Telekatz/Voron-Mods/Clockwork2 CAN/README.md

# Clockwork2 CAN

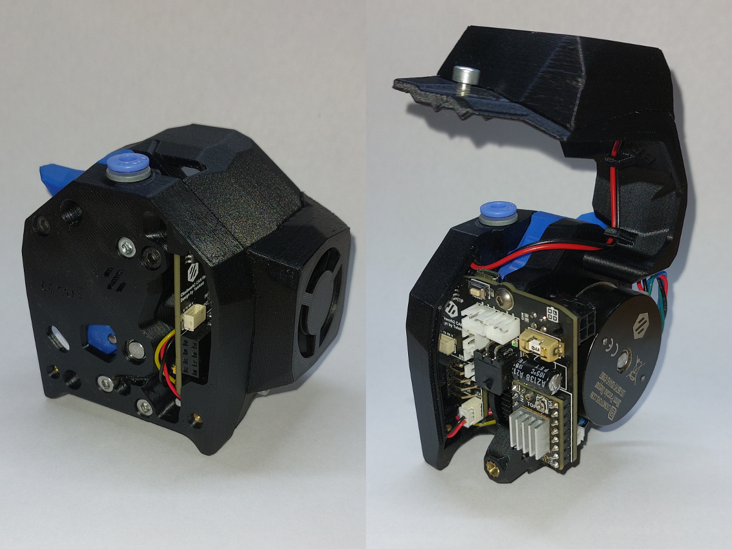
[picture p5: Clockwork2 CAN/Images/Clockwork2.jpg]
Image of Clockwork2 CAN


A CAN toolhead bord designed for the Clockwork 2 in combination with the Klipper firmware. It provides all necessary interfaces for the toolhead. Only 4 wires (2xCAN, 24V GND) are needed to connect the toolhead bord to the host.  

## Features

* 1x CAN-bus and 24V power in port
* 1x TMC2209 SilentStepStick port
* 1x Hotend MOSFET output
* 3x 5V/24V Fan MOSFET outputs (HEF, PCF, Board)
* 2x Fan RPM inputs (HEF, PCF)
* 1x 5V/24V probe input with BAT54C diode
* 3x Thermistor input with 2.2k pullup resistor (hotend, board, TH1)
* 2x endstop inputs (ST1, ST2)
* 1x Filament sensor input (FIL)
* 1x ADXL345 accelerometer for input shaper
* 1x NeoPixel output with 5V level shifter
* 1x USB port
* 1x UART port
