Telekatz/Voron-Mods/Carrot Patch frame mount/Readme.md

# Carrot Patch frame mount

This mod allows to mount an ERCP to the side of a VORON.

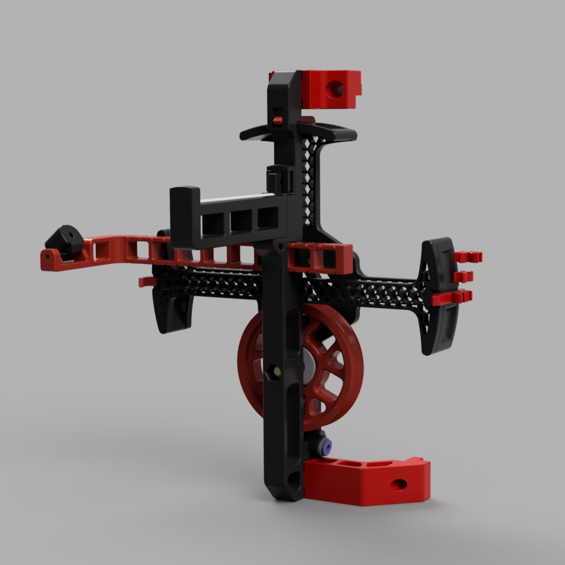
[picture p6: Carrot Patch frame mount/Images/Carrot_Patch_frame_mount_CAD.png]


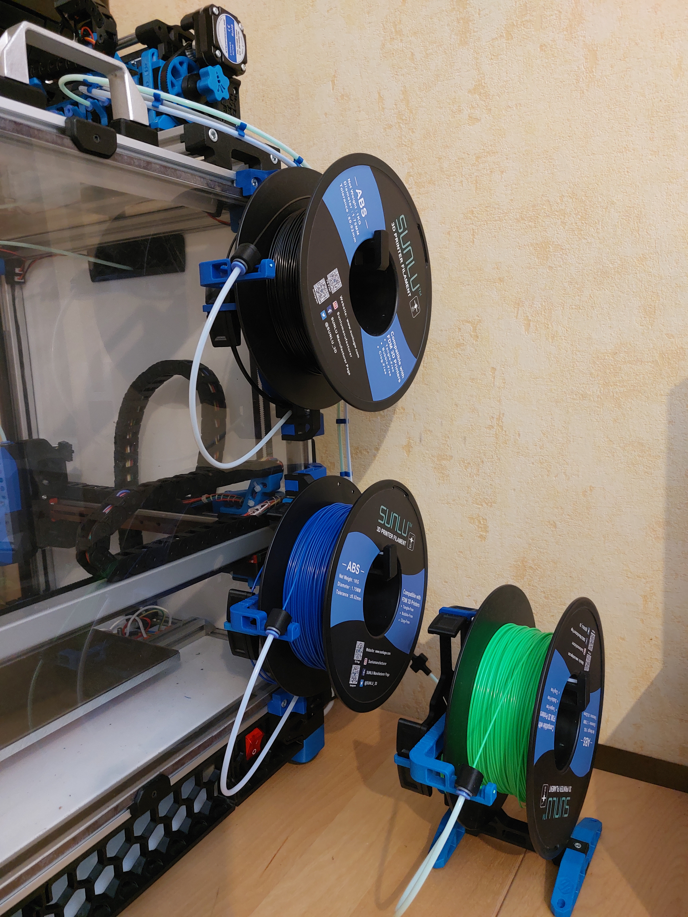
[picture p7: Carrot Patch frame mount/Images/Carrot_Patch_frame_mount.jpg]
