Telekatz/Voron-Mods/Clockwork2 CAN/STL/Tools/PCB_assembly_frame_bottom.stl

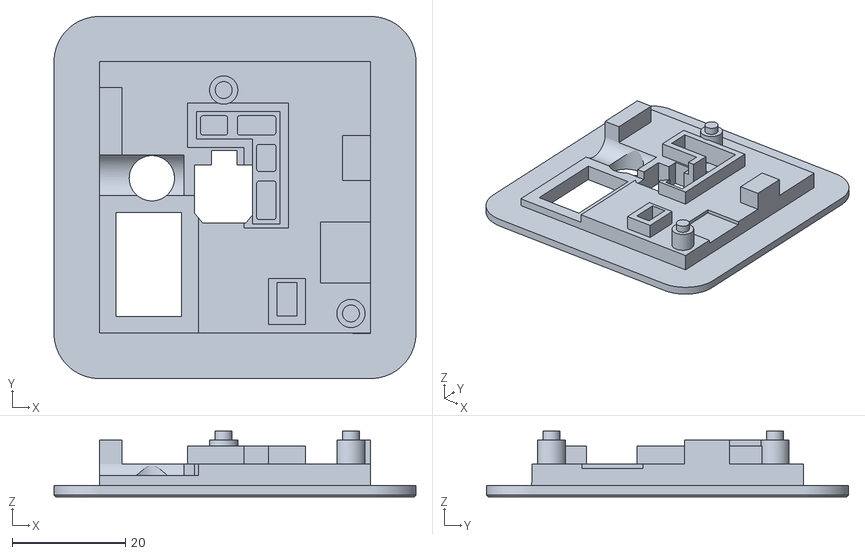
[picture p12: CAD file, 2022-07-31]
Clockwork2 CAN/STL/Tools/PCB_assembly_frame_bottom.stl
64.0 x 64.0 x 11.6
