Telekatz/Voron-Mods/Clockwork2 CAN/STL/Tools/PCB_assembly_frame_top.stl

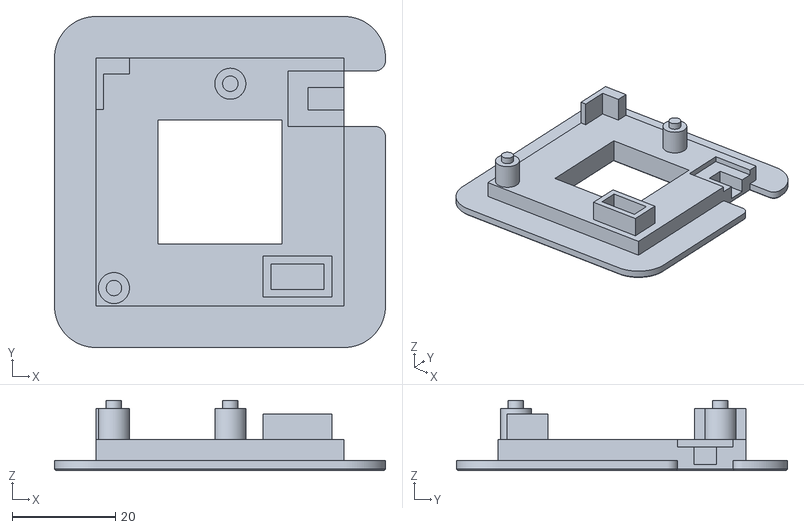
[picture p13: CAD file, 2022-07-31]
Clockwork2 CAN/STL/Tools/PCB_assembly_frame_top.stl
64.0 x 64.0 x 13.6
