Telekatz/Voron-Mods/Carrot Patch frame mount/STL/Main body frame mount.stl

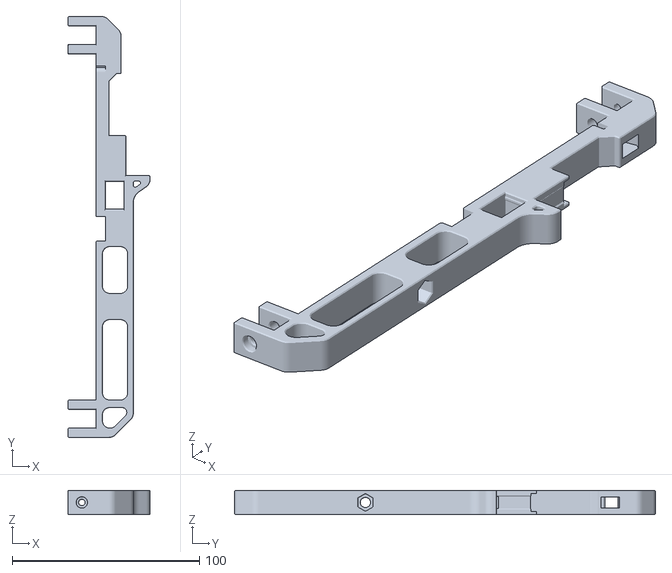
[picture p14: CAD file, 2022-06-19]
Carrot Patch frame mount/STL/Main body frame mount.stl
44.0 x 225.0 x 13.0
