Telekatz/Voron-Mods/Carrot Patch frame mount/STL/frame mount bottom V2 dual 250.stl

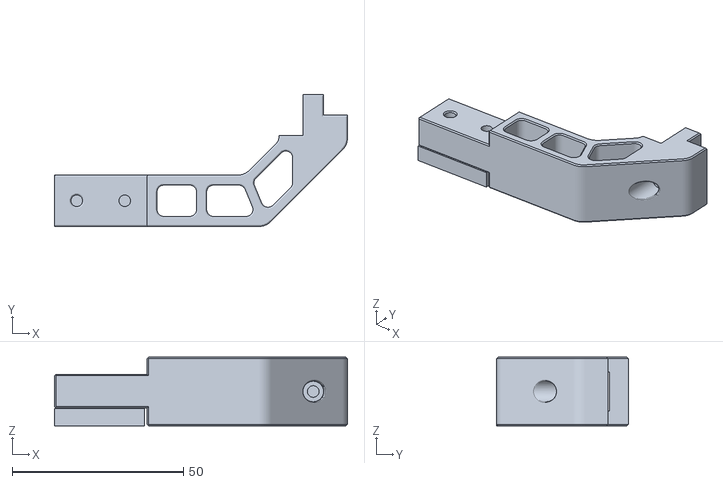
[picture p15: CAD file, 2022-06-19]
Carrot Patch frame mount/STL/frame mount bottom V2 dual 250.stl
85.5 x 38.5 x 20.0
