Telekatz/Voron-Mods/Clockwork2 CAN/STL/3010_Fan_Cover.stl

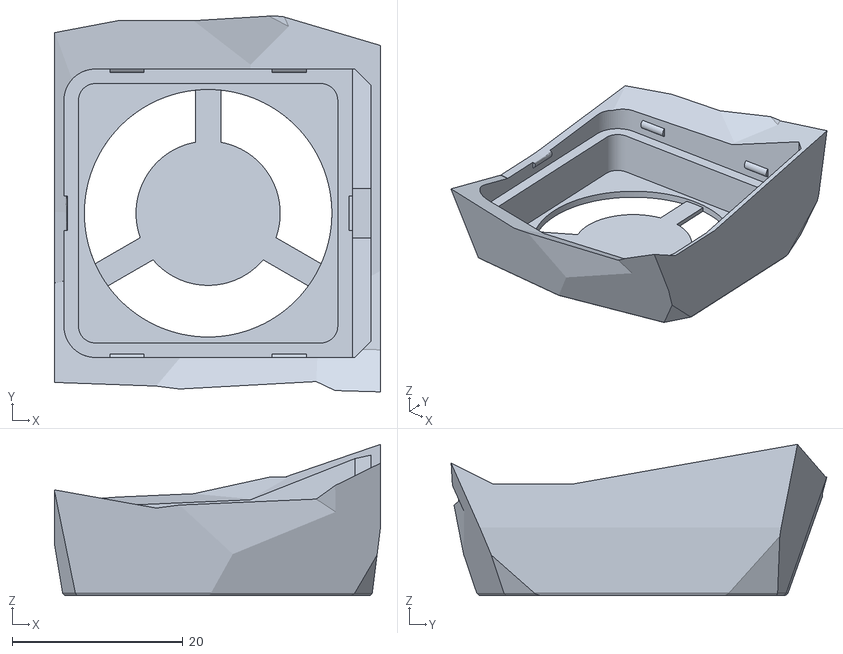
[picture p16: CAD file, 2022-07-31]
Clockwork2 CAN/STL/3010_Fan_Cover.stl
38.2 x 44.0 x 17.7
