Telekatz/Voron-Mods/Drag Knife Toolhead/CAD/Drag Knife Toolhead.stp

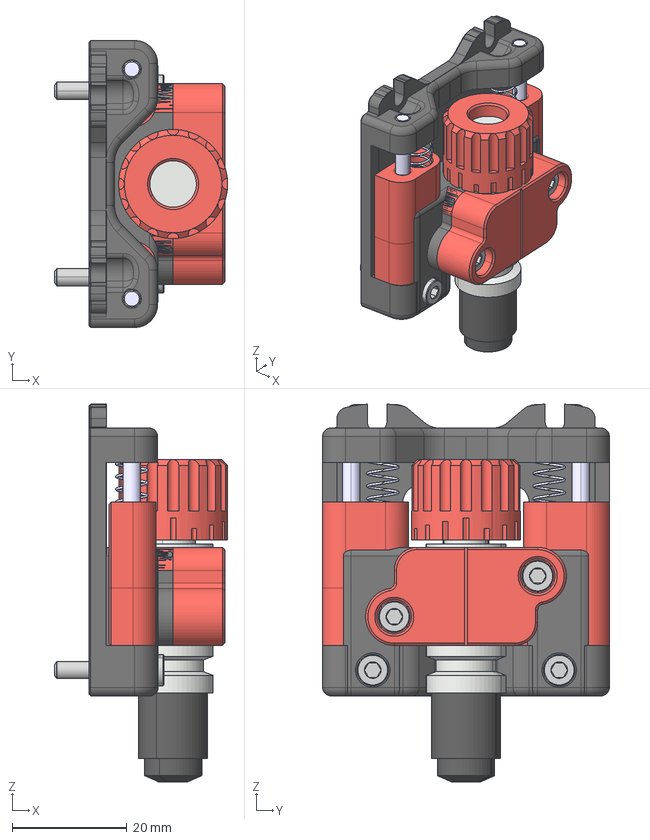
[picture p17: CAD file, 2022-12-06]
Drag Knife Toolhead/CAD/Drag Knife Toolhead.stp
30.2 x 50.0 x 65.9 mm
M3x16 SHCS x 4
M3 Threaded Insert 2 x 4
Drag Knife Baseplate Tap
Drag Knife
Drag Knife Slider Front
Knob
M3x8 SHCS x 2
Spring 5.5x20 x 2
Shaft 3x45 x 2
Drag Knife Baseplate
Drag Knife Slider Back
