Telekatz/Voron-Mods/Drag Knife Toolhead/STL/Drag Knife Baseplate Tap.stl

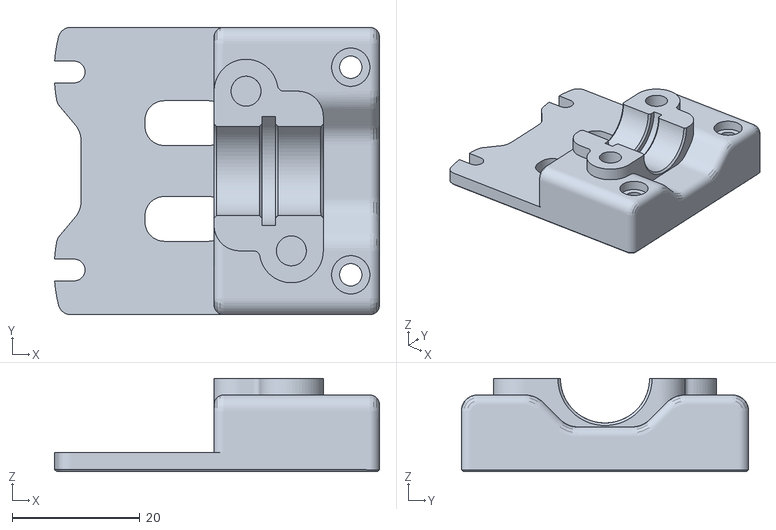
[picture p18: CAD file, 2022-12-06]
Drag Knife Toolhead/STL/Drag Knife Baseplate Tap.stl
50.9 x 45.0 x 14.6
