Telekatz/Voron-Mods/Carrot Patch frame mount/STL/Tube clip x3.stl

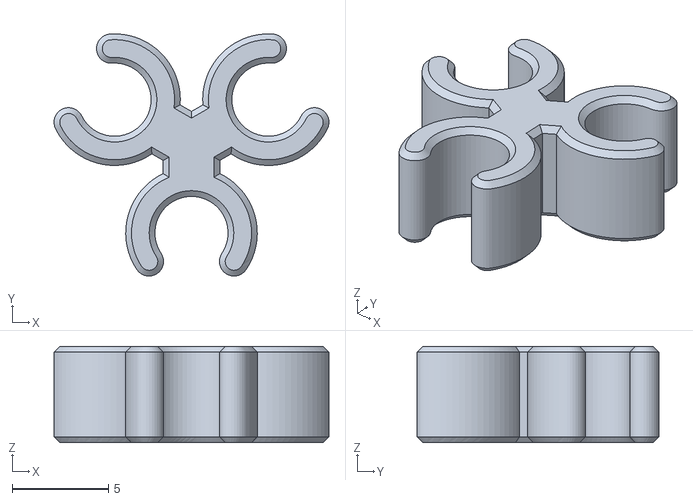
[picture p19: CAD file, 2022-06-19]
Carrot Patch frame mount/STL/Tube clip x3.stl
14.3 x 12.6 x 5.00
