Telekatz/Voron-Mods/Clockwork2 CAN/STL/Sensor_Locker.stl

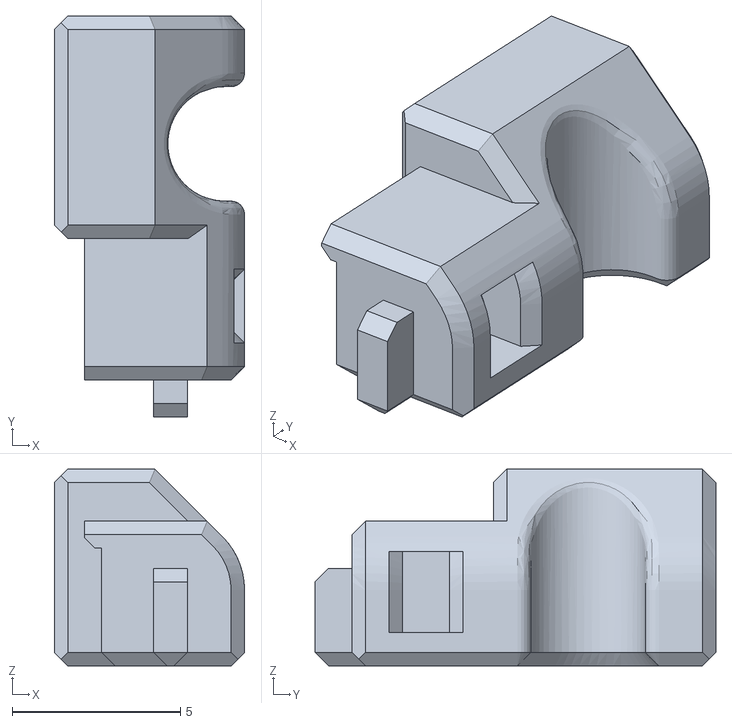
[picture p20: CAD file, 2022-07-31]
Clockwork2 CAN/STL/Sensor_Locker.stl
5.65 x 11.9 x 5.85
