Telekatz/Voron-Mods/Clockwork2 CAN/STL/Tools/SB_header_soldering_jig.stl

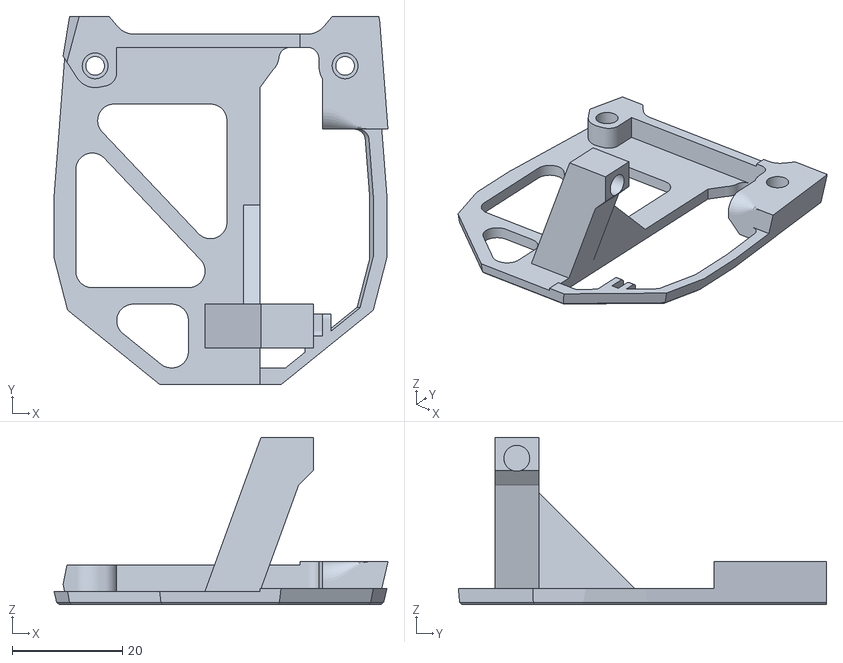
[picture p21: CAD file, 2022-07-31]
Clockwork2 CAN/STL/Tools/SB_header_soldering_jig.stl
60.7 x 66.9 x 30.4
