Telekatz/Voron-Mods/Drag Knife Toolhead/STL/Drag Knife Slider Front.stl

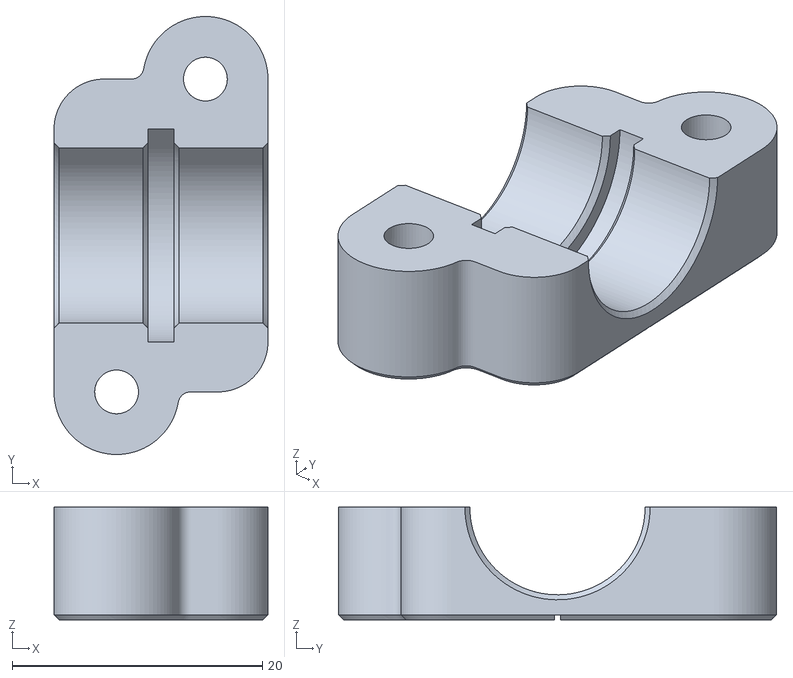
[picture p22: CAD file, 2022-06-26]
Drag Knife Toolhead/STL/Drag Knife Slider Front.stl
17.1 x 35.0 x 9.00
