Telekatz/Voron-Mods/Carrot Patch frame mount/STL/Frame mount top.stl

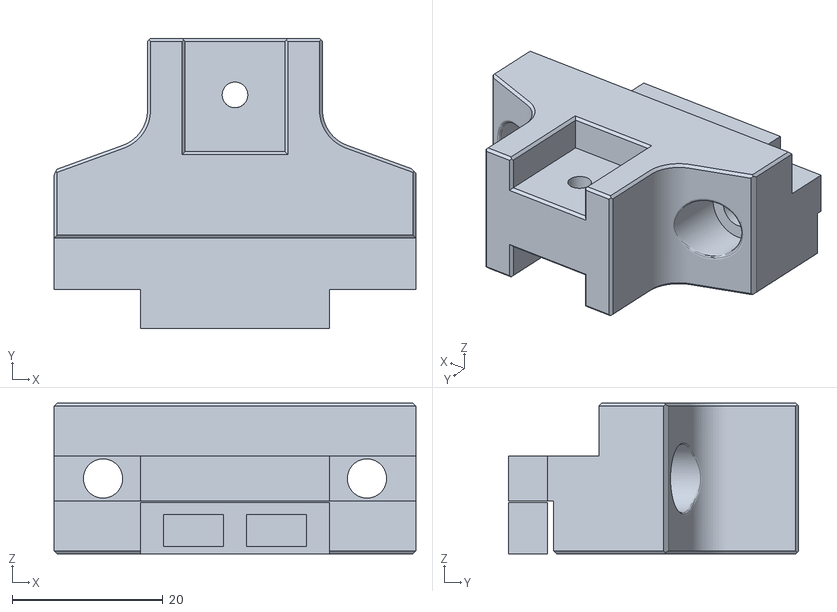
[picture p23: CAD file, 2022-06-19]
Carrot Patch frame mount/STL/Frame mount top.stl
48.0 x 38.5 x 20.0
