Telekatz/Voron-Mods/Clockwork2 CAN/STL/SB_PCB_mount.stl

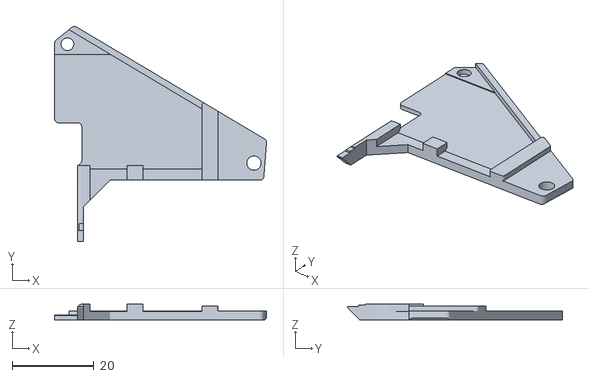
[picture p24: CAD file, 2022-07-31]
Clockwork2 CAN/STL/SB_PCB_mount.stl
51.8 x 52.6 x 3.80
