Telekatz/Voron-Mods/Drag Knife Toolhead/STL/Drag Knife Slider Back.stl

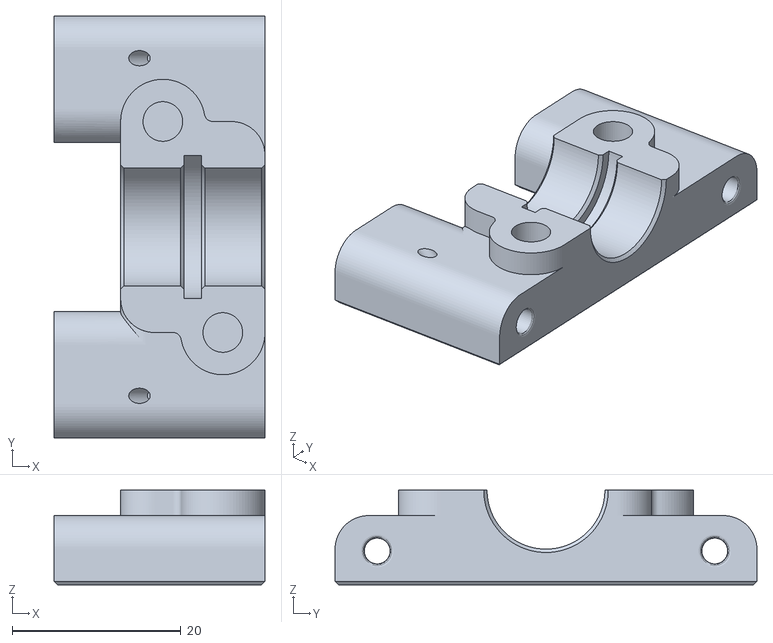
[picture p25: CAD file, 2022-06-26]
Drag Knife Toolhead/STL/Drag Knife Slider Back.stl
25.0 x 50.0 x 11.2
