Telekatz/Voron-Mods/Carrot Patch frame mount/STL/Locker Tube.stl

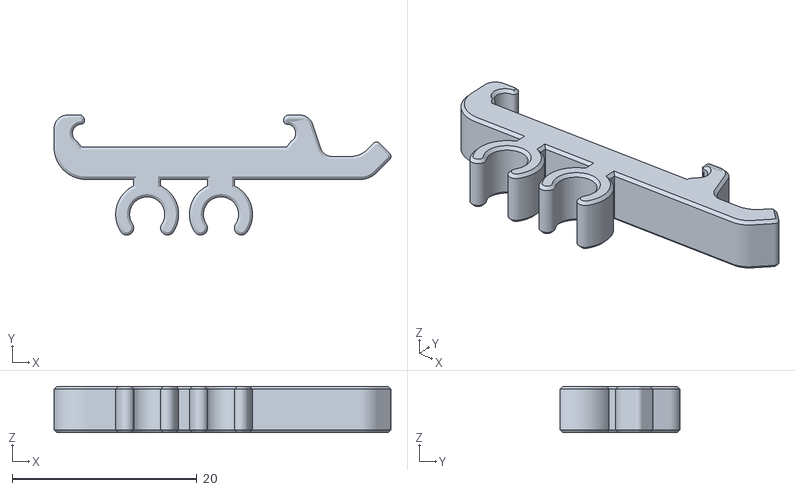
[picture p26: CAD file, 2022-06-19]
Carrot Patch frame mount/STL/Locker Tube.stl
36.5 x 13.0 x 5.00
