Telekatz/Voron-Mods/Clockwork2 CAN/STL/motor_plate_CW2CAN.stl

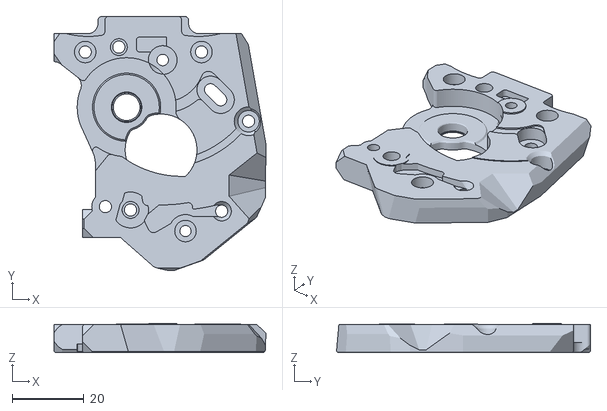
[picture p27: CAD file, 2022-07-31]
Clockwork2 CAN/STL/motor_plate_CW2CAN.stl
59.1 x 70.8 x 8.20
