Telekatz/Voron-Mods/Drag Knife Toolhead/STL/Drag Knife Baseplate.stl

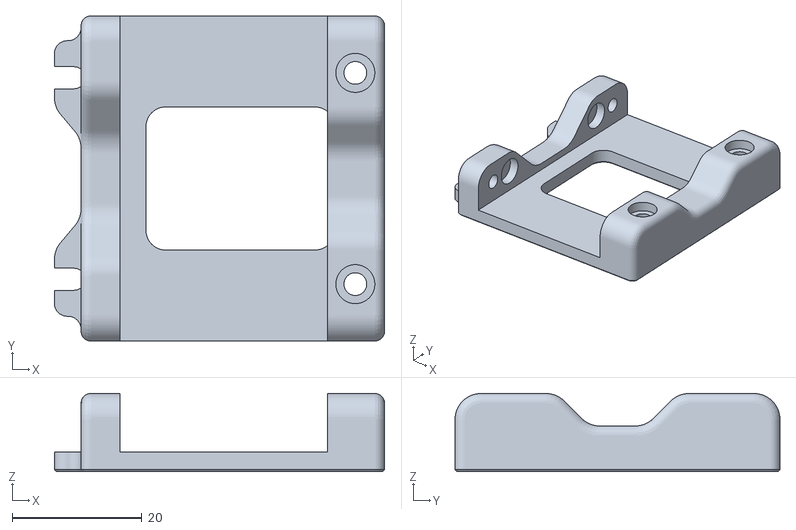
[picture p28: CAD file, 2022-06-26]
Drag Knife Toolhead/STL/Drag Knife Baseplate.stl
50.8 x 50.0 x 12.0
