Telekatz/Voron-Mods/Clockwork2 CAN/STL/Latch_CW2CAN.stl

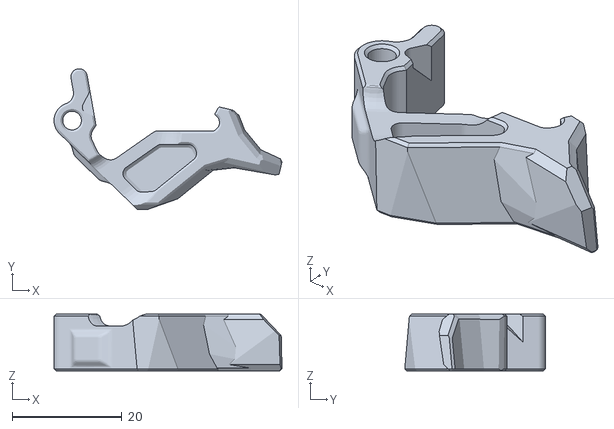
[picture p29: CAD file, 2022-07-31]
Clockwork2 CAN/STL/Latch_CW2CAN.stl
41.6 x 25.6 x 10.4
