Telekatz/Voron-Mods/Drag Knife Toolhead/STL/Knob.stl

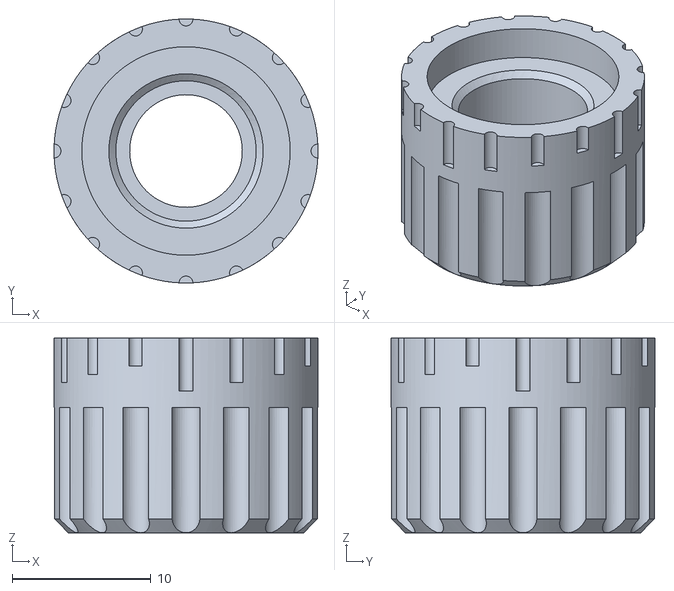
[picture p30: CAD file, 2022-06-26]
Drag Knife Toolhead/STL/Knob.stl
19.0 x 19.0 x 14.0
