Telekatz/Voron-Mods/Carrot Patch frame mount/STL/Tube clip x2.stl

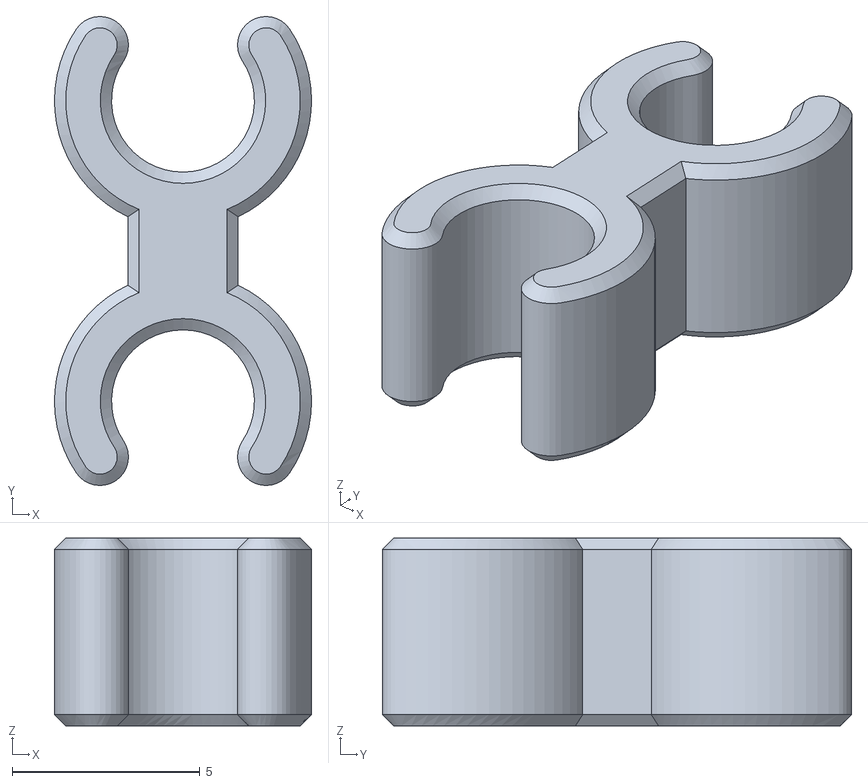
[picture p31: CAD file, 2022-06-19]
Carrot Patch frame mount/STL/Tube clip x2.stl
6.84 x 12.5 x 5.00
