Telekatz/Voron-Mods/Clockwork2 CAN/STL/cable_cover_fan.stl

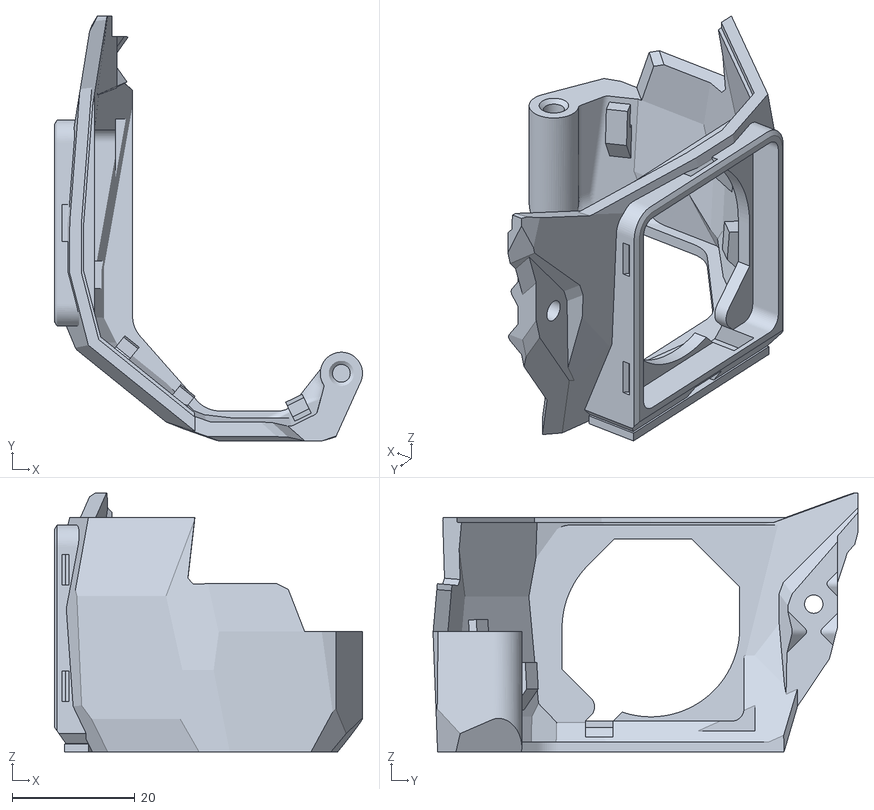
[picture p32: CAD file, 2022-07-31]
Clockwork2 CAN/STL/cable_cover_fan.stl
50.3 x 69.4 x 42.2
