Telekatz/Voron-Mods/Carrot Patch frame mount/STL/frame mount bottom V2.stl

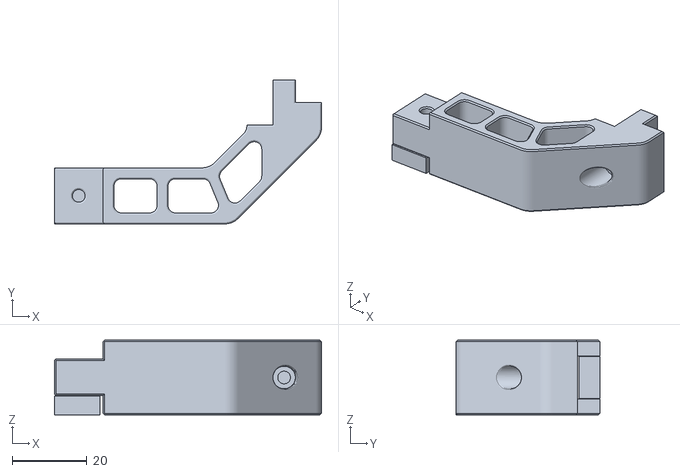
[picture p33: CAD file, 2022-06-19]
Carrot Patch frame mount/STL/frame mount bottom V2.stl
71.5 x 38.5 x 20.0
