Telekatz/Voron-Mods/(commit log)

2022-06-19 Carrot Patch frame mount added
    [Frame mount top.stl, Locker Tube.stl, Main body frame mount.stl, Tube clip x2.stl, Tube clip x3.stl, frame mount bottom V2 dual 250.stl, frame mount bottom V2.stl]
2022-06-26 Drag Knife Toolhead added
    [Drag Knife Baseplate.stl, Drag Knife Slider Back.stl, Drag Knife Slider Front.stl, Drag Knife Toolhead.stp, Klipper.cfg, Knob.stl, config.cfg]
2022-07-31 Clockwork2 CAN added
    [3010_Fan_Cover.stl, CW2-CAN.cfg, Latch_CW2CAN.stl, PCB_assembly_frame_bottom.stl, PCB_assembly_frame_top.stl, SB_PCB_mount.stl, SB_header_soldering_jig.stl, Sensor_Locker.stl]
2022-08-22 Update Readme.md
    Update BOM
2022-12-06 Add Voron Tap version of drag knife toolhead
    [Drag Knife Baseplate Tap.stl, Drag Knife Toolhead.stp, config.cfg]
